itsmeshivam885/SmartBin-1/docs/SmartBin-1_Design_Calculation_Report.pdf

DESIGN CALCULATION REPORT
MEE2014 · Group 3 · B.Tech CSE (BCE) · VIT Bhopal University

# SmartBin-1

## Ranging · Level-shifting · Calibration · Error & Power Analysis

Automated IoT Waste-Level Monitoring & Alert System · Prototype V1.0

REPORT DATE
01 Oct 2026

PREPARED BY
Shivam Singh · Aryan Singh

REG. NO.
25BCE10736 · 25BCE10798

BASIS
Project report + prototype tests
SmartBin-1 · School of Computer Science and Engineering (SCOPE), VIT Bhopal University | Page 1

±2.88 %

WORST-CASE SENSOR ERROR

# 3.33 V

ECHO LEVEL AT GPIO18

# 6.4 mA

MAX LED CURRENT

≈ 5 Hz

SENSING RATE (201 ms)

### 01 DESIGN INPUTS & ASSUMPTIONS

Symbol | Quantity | Value | Basis
Dempty | Calibrated sensor-to-bottom depth | 14.4 cm | Project report / firmware
Dfull | Distance at 100 % fill (headroom above min range) | 4.0 cm | Project report / firmware
S | Usable span = Dempty − Dfull | 10.4 cm | Calculated
v | Speed of sound used by firmware (≈ 20 °C) | 343 m/s = 0.0343 cm/µs | Firmware constant
±e | HC-SR04 nominal ranging accuracy | ±0.3 cm | Sensor datasheet (nominal)
R1 / R2 | ECHO divider (R2 = two 1 kΩ in series) | 1 kΩ / 2 kΩ, 5 % tol. | Bill of materials
RLED | LED series resistor (×3) | 220 Ω | Bill of materials

Vcc

/ Vio | Sensor & buzzer rail / ESP32 GPIO level | 5 V (USB/VIN) / 3.3 V | ESP32 DevKit V1

t

out, tloop, t poll | Echo timeout / loop delay / dashboard poll | 30 ms / 200 ms / 500 ms | Firmware & dashboard

### 02 ULTRASONIC RANGING

The HC-SR04 raises ECHO for the round-trip flight time t of a 40 kHz burst. The one-way distance and its inverse are:
D = t · v / 2 = t × 0.0343 / 2 | ⇔ | t = 2D / v = 2D / 0.0343
Condition | D (cm) | Echo time t (µs) | Working
Empty bin (0 %) | 14.4 | 839.7 | 2 × 14.4 / 0.0343
Half-full alert (50 %) | 9.2 | 536.4 | 2 × 9.2 / 0.0343
Full alert (80 %) | 6.08 | 354.5 | 2 × 6.08 / 0.0343
Full bin (100 %) | 4.0 | 233.2 | 2 × 4.0 / 0.0343
Firmware lower clamp | 2.0 | 116.6 | 2 × 2.0 / 0.0343

Resolution: pulseIn() counts in 1 µs steps → ΔD = 0.0343 / 2 = 0.01715 cm per tick = 0.165 % of the 10.4 cm span (negligible). Timeout: 30 000 µs corresponds to 30 000 × 0.0343 / 2 = 514.5 cm, beyond the sensor's rated range, so the timeout only catches a lost echo (firmware then reports the bin as empty).

### 03 ECHO LEVEL-SHIFTING (VOLTAGE DIVIDER)

HC-SR04 ECHO

5 V pulse

R1 1 kΩ | GPIO18 (D18)

R2 = 2 × 1 kΩ = 2 kΩ

GND (common)

V_out = 3.33 V

The HC-SR04 drives ECHO at 5 V but ESP32 GPIOs are 3.3 V devices. A 1 kΩ / 2 kΩ divider scales the pulse:
V

out = Vin · R2 / (R1 + R2)
= 5 × 2 k / 3 k = 3.33 V

Divider current I = 5 / 3 kΩ = 1.67 mA; source impedance R1 ∥ R2 = 667 Ω, so with ≈10 pF pin capacitance (assumed) τ ≈ 6.7 ns — negligible against the 1 µs timing resolution.

Case | R1 | R2 | V_out | Check (V_IH ≈ 0.75 V_DD = 2.48 V; GPIO max ≈ 3.6 V)
Nominal | 1.00 kΩ | 2.00 kΩ | 3.333 V | HIGH recognised ✓ · within limit ✓
Worst low (±5 %) | 1.05 kΩ | 1.90 kΩ | 3.220 V | 5 × 1.9 / 2.95 → HIGH recognised ✓
Worst high (±5 %) | 0.95 kΩ | 2.10 kΩ | 3.443 V | 5 × 2.1 / 3.05 → below 3.6 V ✓

SmartBin-1 | Design Calculation Report
SmartBin-1 · School of Computer Science and Engineering (SCOPE), VIT Bhopal University | Page 2
Case | R1 | R2 | V_out | Check (V_IH ≈ 0.75 V_DD = 2.48 V; GPIO max ≈ 3.6 V)
No divider (direct) | — | — | 5.00 V | 1.4 V above GPIO limit ✗ (stress / damage risk)

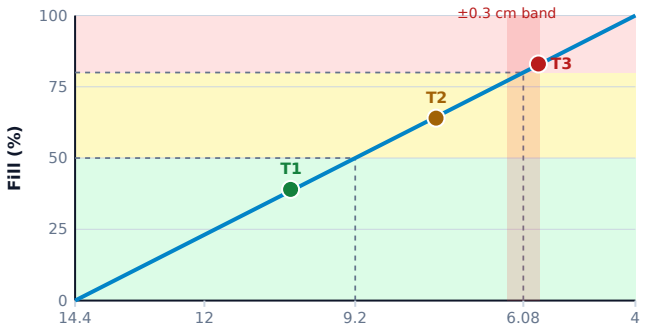
[picture p11: figure]
Fill (%); ±0.3 cm band

SmartBin-1 · School of Computer Science and Engineering (SCOPE), VIT Bhopal University | Page 3

### 04 FILL CALIBRATION & ALERT THRESHOLDS

Fill is linear in distance over the 10.4 cm span (firmware: round() then constrain(0,100)):
Fill % = (Dempty − D) / (Dempty − Dfull) × 100 = (14.4 − D) / 10.4 × 100 | | | Dx% = 14.4 − 0.104·x

Sensor-to-waste distance D (cm) ← closer = fuller

Fill | D (cm) | Status | LED | Buzzer
< 50 % | > 9.2 | OK | Green · GPIO14 | OFF
50–79 % | 6.08 – 9.2 | HALF FULL | Yellow · GPIO27 | OFF
≥ 80 % | ≤ 6.08 | FULL | Red · GPIO26 | ON · 2500 Hz

Thresholds: 50 % → 14.4 − 5.2 = 9.2 cm; 80 % → 14.4 − 8.32 = 6.08 cm. 1 % of fill = 0.104 cm of distance. Shaded strip = ±0.3 cm sensor accuracy around the 80 % alarm point.

### Verification against prototype tests

Test | D shown | Calculated fill | Reporte
d
Δ | State · indicators
T1 | 10.4 cm | (14.4−10.4)/10.4 = 38.5 % | 39 % | +0.5 % | OK · green LED, buzzer off
T2 | 7.7 cm | (14.4−7.7)/10.4 = 64.4 % | 64 % | −0.4 % | HALF FULL · yellow LED, buzzer off
T3 | 5.8 cm | (14.4−5.8)/10.4 = 82.7 % | 83 % | +0.3 % | FULL · red LED, buzzer on

Differences are rounding only (the dashboard shows distance to 0.1 cm while the device computes fill from the unrounded reading).

### 05 LED CURRENT-LIMIT DESIGN

I = (VGPIO − VF

) / R | | | Rmin = (3.3 − VF
) / I
max

| PR
= I²R
LED | Typical V_F* | I at 220 Ω | P in resistor | Min R for 12
mA | Check
Green (3 mm) | 2.2 V | (3.3−2.2)/220 = 5.0 mA | 5.5 mW | 92 Ω | ✓ safe
Yellow (3 mm) | 2.0 V | (3.3−2.0)/220 = 5.9 mA | 7.7 mW | 108 Ω | ✓ safe
Red (5 mm) | 1.9 V | (3.3−1.9)/220 = 6.4 mA | 8.9 mW | 117 Ω | ✓ safe

*Typical forward voltages assumed, not measured. Only one LED is lit at a time, so peak LED current is 6.4 mA — about half of a conservative 12 mA per-pin budget and far below the 250 mW resistor rating. 220 Ω gives visible brightness with large margin.

### 06 ERROR ANALYSIS

Errorfill = ± e / S × 100 = ± (0.3 / 10.4) × 100 = ± 2.88 % (sensor accuracy, ideal line of sight, ≈ 20 °C)

Error source | Magnitude | Effect on fill | Status
HC-SR04 accuracy | ±0.3 cm | ±2.88 % | Dominant, as reported
Timer quantisation (1 µs) | 0.017 cm | ±0.08 % | Negligible
Integer rounding of fill | — | ±0.5 % | Display only
Speed of sound at 20 °C (343.4 vs 343) | +0.12 % | ≤ 0.17 % at D = 14.4 | Negligible
Speed of sound at 30 °C (349.5 m/s) | +1.88 % | ≈ 2.6 % at D = 14.4 | Not compensated
Speed of sound at 40 °C (355.5 m/s) | +3.65 % | ≈ 5.1 % at D = 14.4 | Not compensated

Temperature rows use v ≈ 331.3 + 0.606·T (m/s). Distance error scales with D, so the effect is largest when the bin is nearly empty. Worst-case combined at 30 °C ≈ 2.88 + 2.6 ≈ 5.5 %; at 40 °C ≈ 7.9 % (linear sum). These go beyond the room-condition tests in the project report.

Threshold margin flag: Test 3 (5.8 cm) lies only 0.28 cm from the 80 % alarm point (6.08 cm) — inside the ±0.3 cm accuracy band. Near that boundary a reading can jitter between yellow and red/buzzer. A 3–5 sample median and a small hysteresis (e.g. alarm ON at 6.08 cm, OFF at 6.4 cm) would remove flicker.

### 07 POWER BUDGET (5 V USB SUPPLY)

Load | Typical | Peak | Note
ESP32 DevKit (Wi-Fi AP active) | 120 mA | 240 mA | Estimate; Wi-Fi TX bursts
HC-SR04 ultrasonic sensor | 15 mA | 15 mA | Typical datasheet value

SmartBin-1 · School of Computer Science and Engineering (SCOPE), VIT Bhopal University | Page 4
Load | Typical | Peak | Note
LED (one at a time) | 6.4 mA | 6.4 mA | Calculated in §05
Active buzzer module (FULL state only) | 30 mA | 30 mA | Assumed; confirm on bench
Total | 171.4 mA | 291.4 mA | P = 5 V × I = 0.86 W typ. / 1.46 W peak

A standard USB 2.0 port supplies 500 mA, leaving ≥ 208 mA (≈ 42 %) margin at peak. All currents here are datasheet-type estimates, not bench measurements.

### 08 TIMING & RESPONSIVENESS

Quantity | Working | Result
Loop period | 200 ms delay + ≤ 0.84 ms echo + 12 µs trigger + web service ≈
201 ms | ≈ 5 Hz sensing
Local alert latency (LED / buzzer) | ≤ one loop period | ≤ 0.2 s
Dashboard refresh | JavaScript polls /data every 500 ms | 2 Hz
Worst-case remote display latency | 500 ms poll + 201 ms sample age | ≈ 0.7 s
Wi-Fi coverage (AP mode) | On-board antenna, line of sight (project report) | ≈ 15 – 30 m

### 09 DESIGN CHECK SUMMARY

Item | Criterion | Result | Status
ECHO input voltage | ≤ 3.6 V and ≥ 2.48 V | 3.22 – 3.44 V (±5 % resistors) | PASS
LED pin current | ≤ 12 mA per pin | 6.4 mA max | PASS
Test accuracy | |calculated − reported| ≤ 1 % | ≤ 0.5 % (rounding) | PASS
Sensor accuracy | Report claim ±2.88 % | ±2.88 % at ≈ 20 °C | PASS
Supply current | ≤ 500 mA (USB 2.0) | ≈ 291 mA peak (estimate) | PASS
80 % alarm margin | Margin > ±0.3 cm | 0.28 cm at Test 3 | FLAG
Temperature drift | < 3 % fill | 2.6 % @30 °C · 5.1 % @40 °C | FLAG
Buzzer idle state | Silent below 80 % | Module is marked “low-level trigger”; silent in
tests | CHECK

### Recommended improvements

- Add a 3–5 sample median filter and ~0.3 cm hysteresis at the 50 % and 80 % thresholds.
- Compensate the speed of sound with a temperature sensor: v = 331.3 + 0.606·T.
- Bench-measure LED forward voltage and total supply current to replace the typical values used here.
- Re-verify the buzzer's silent idle level after any firmware change (low-level-trigger module).
