itsmeshivam885/SmartBin-1/docs/SmartBin-1 CAD Prototype Diagram.pdf

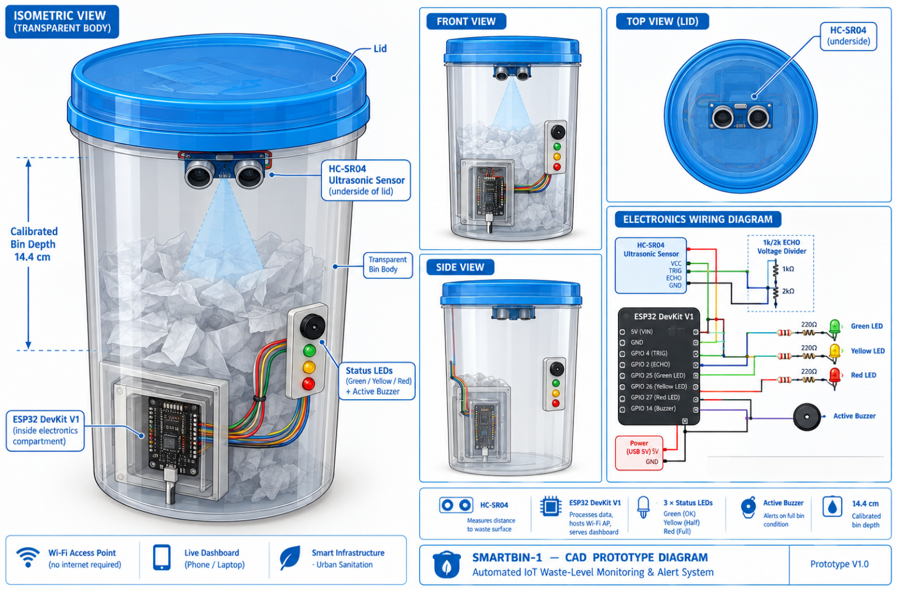
[picture p15: page 1]
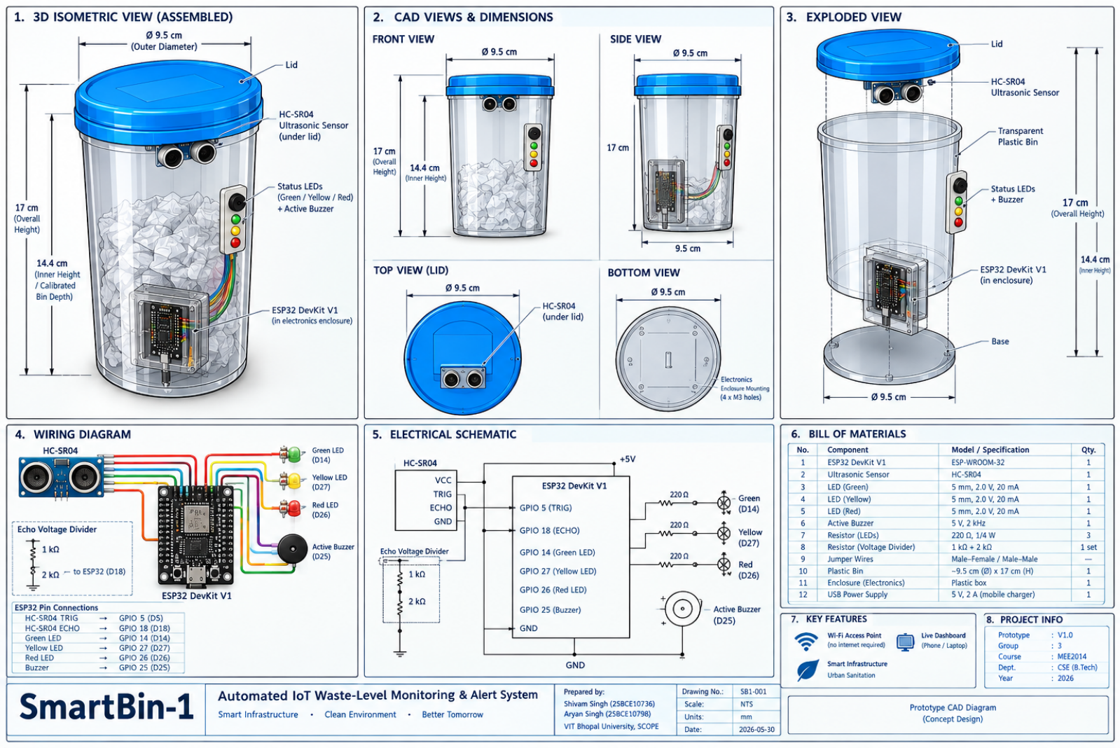
[picture p16: page 2]
