itsmeshivam885/SmartBin-1/images/1790955332914.jpg

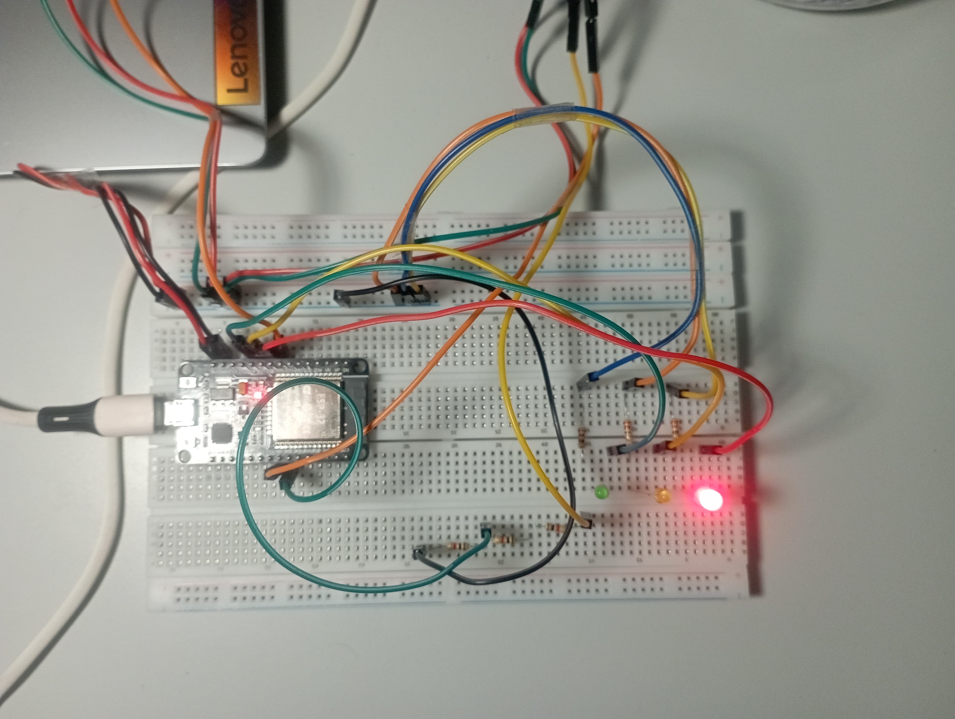
images/1790955332914.jpg
