itsmeshivam885/SmartBin-1/images/1790955332980.jpg

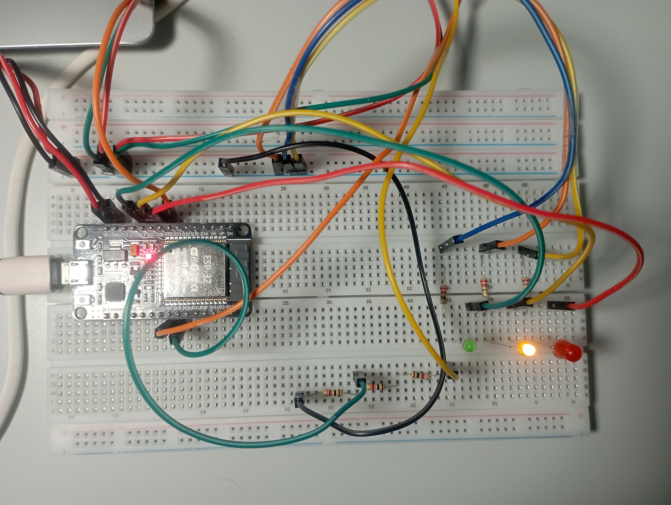
images/1790955332980.jpg
