itsmeshivam885/SmartBin-1/images/IMG_20260928_111834.jpg

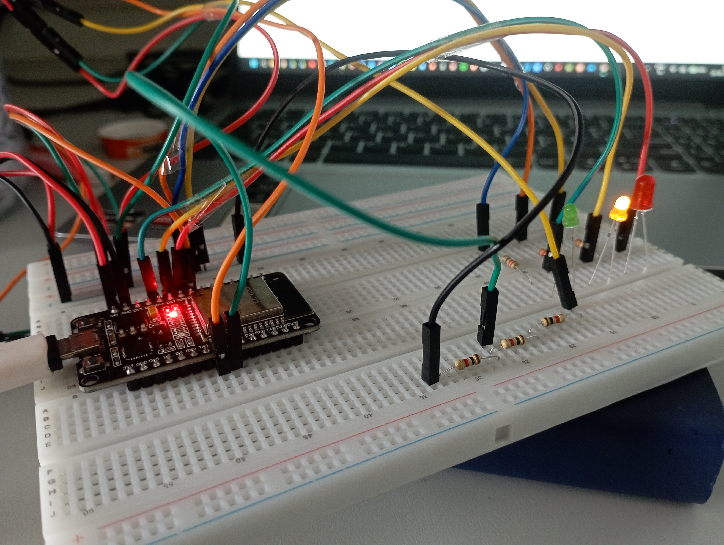
images/IMG_20260928_111834.jpg
