itsmeshivam885/SmartBin-1/images/IMG_20260928_111958.jpg

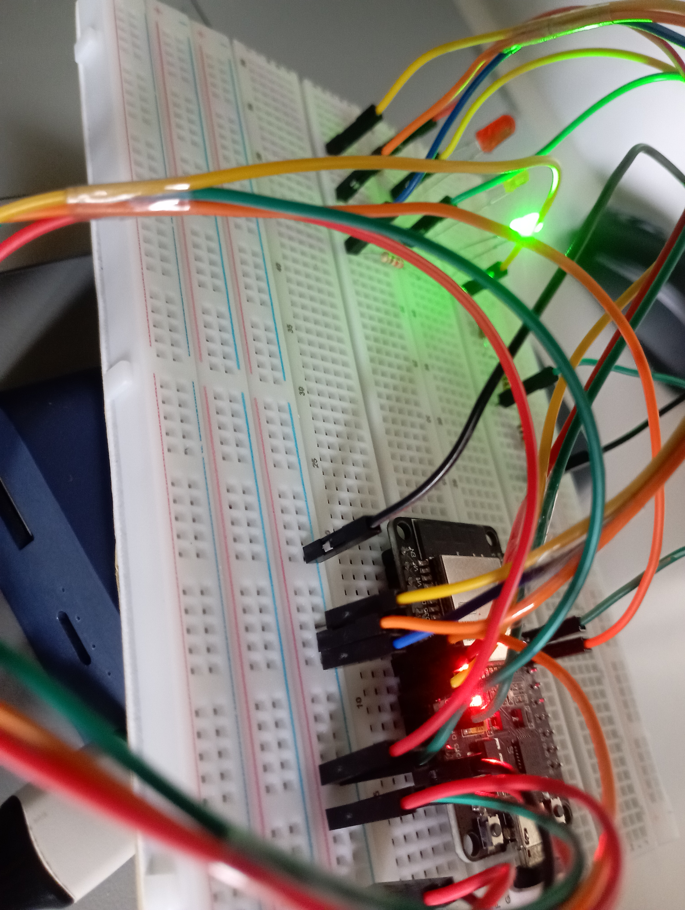
images/IMG_20260928_111958.jpg
