itsmeshivam885/SmartBin-1/images/Screenshot 2026-10-01 221850.png

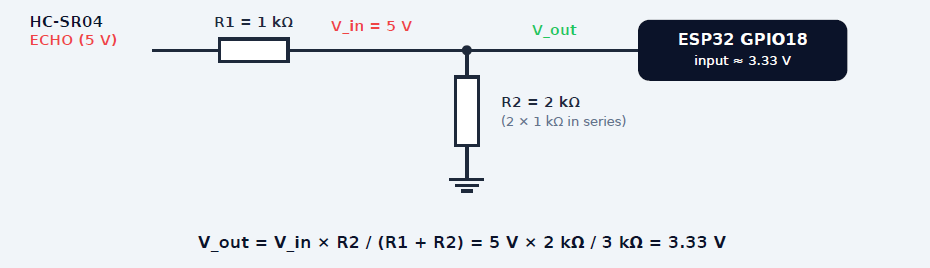
images/Screenshot 2026-10-01 221850.png
