itsmeshivam885/SmartBin-1/(notices)

Notices in the files:
README.md:
License: MIT
